garamizo/BipedRobot/imgs/exploded.png

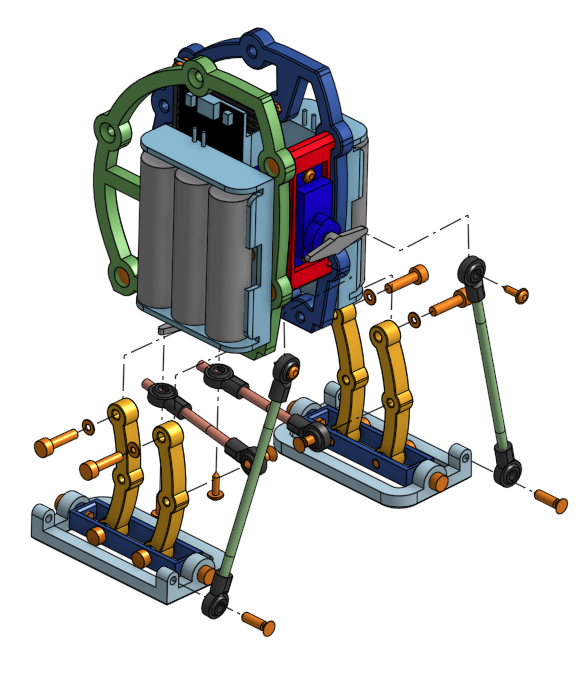
imgs/exploded.png
