garamizo/BipedRobot/imgs/giant.png

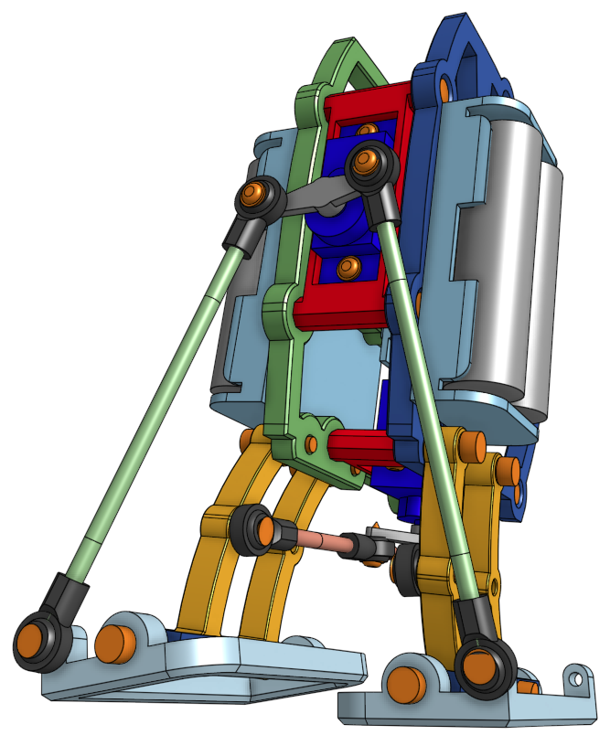
imgs/giant.png
