garamizo/BipedRobot/docs/drawings/BPD100B Robot.pdf

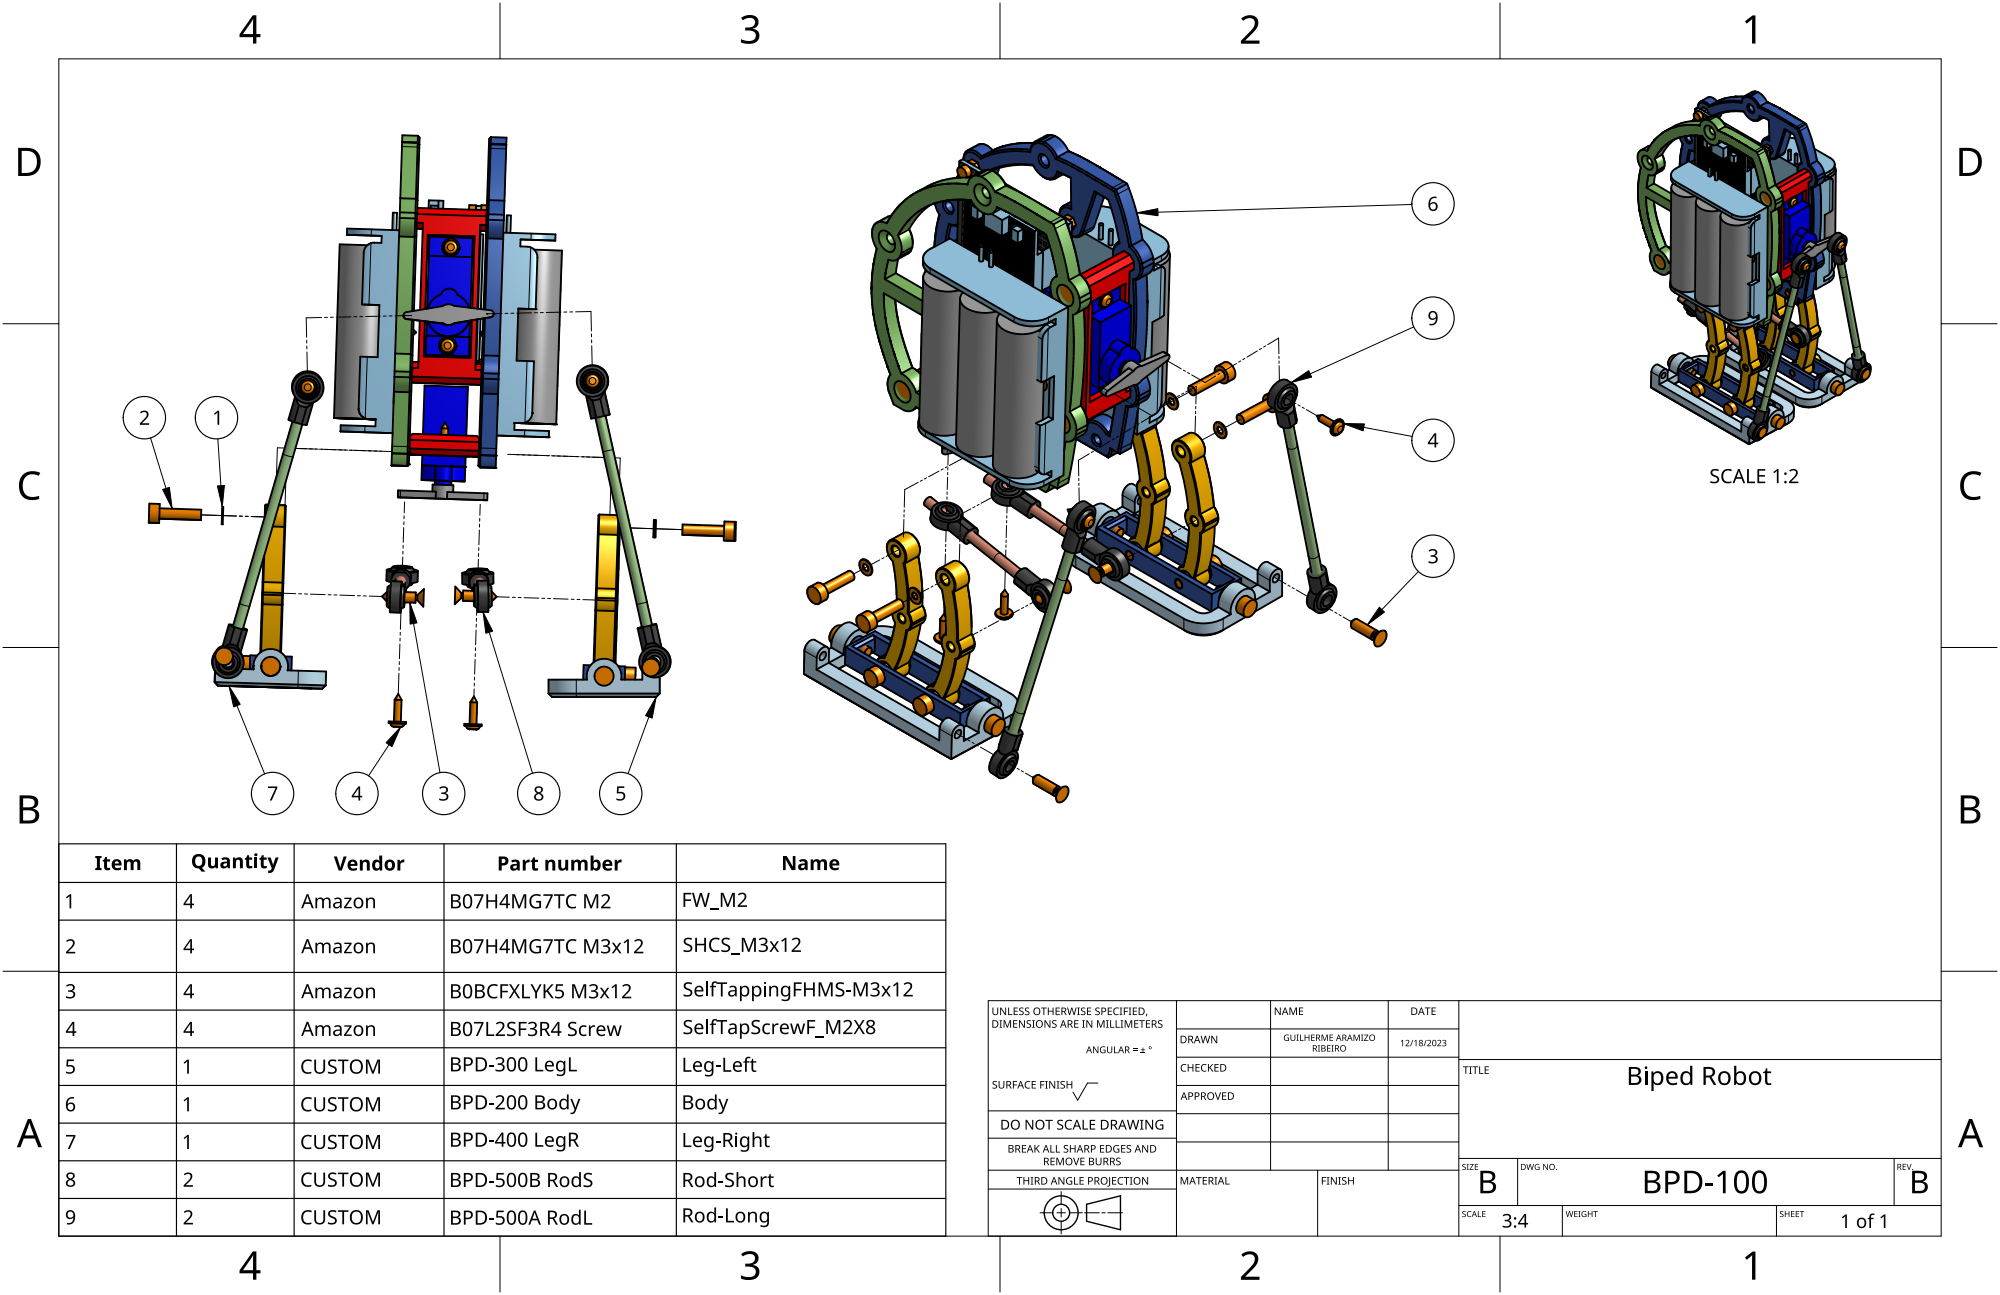
[picture p8: page 1]
