garamizo/BipedRobot/docs/drawings/BPD200B Body.pdf

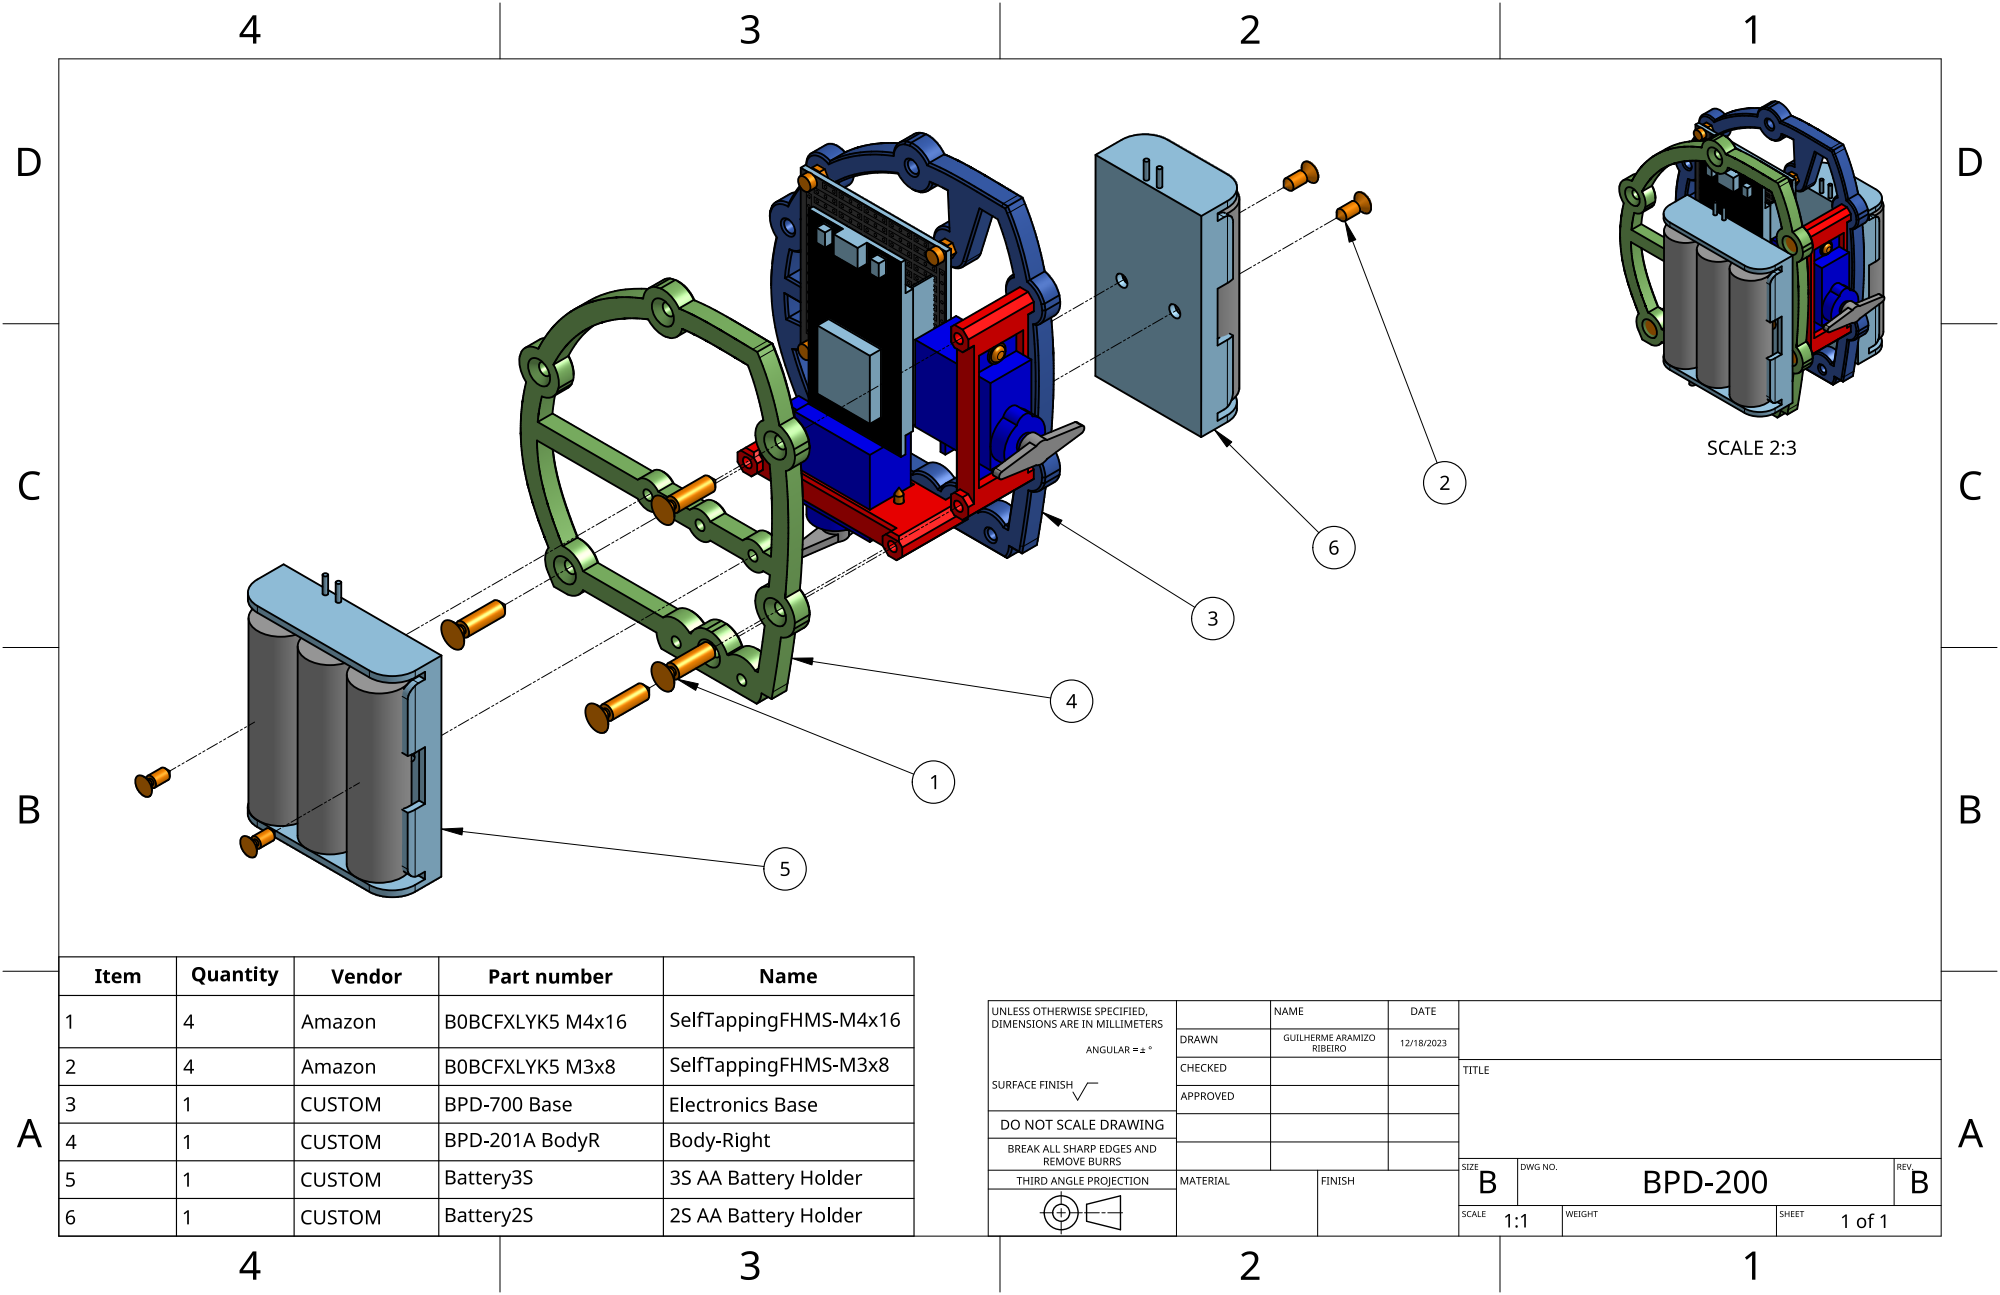
[picture p9: page 1]
