garamizo/BipedRobot/docs/drawings/BPD300A Leg Left.pdf

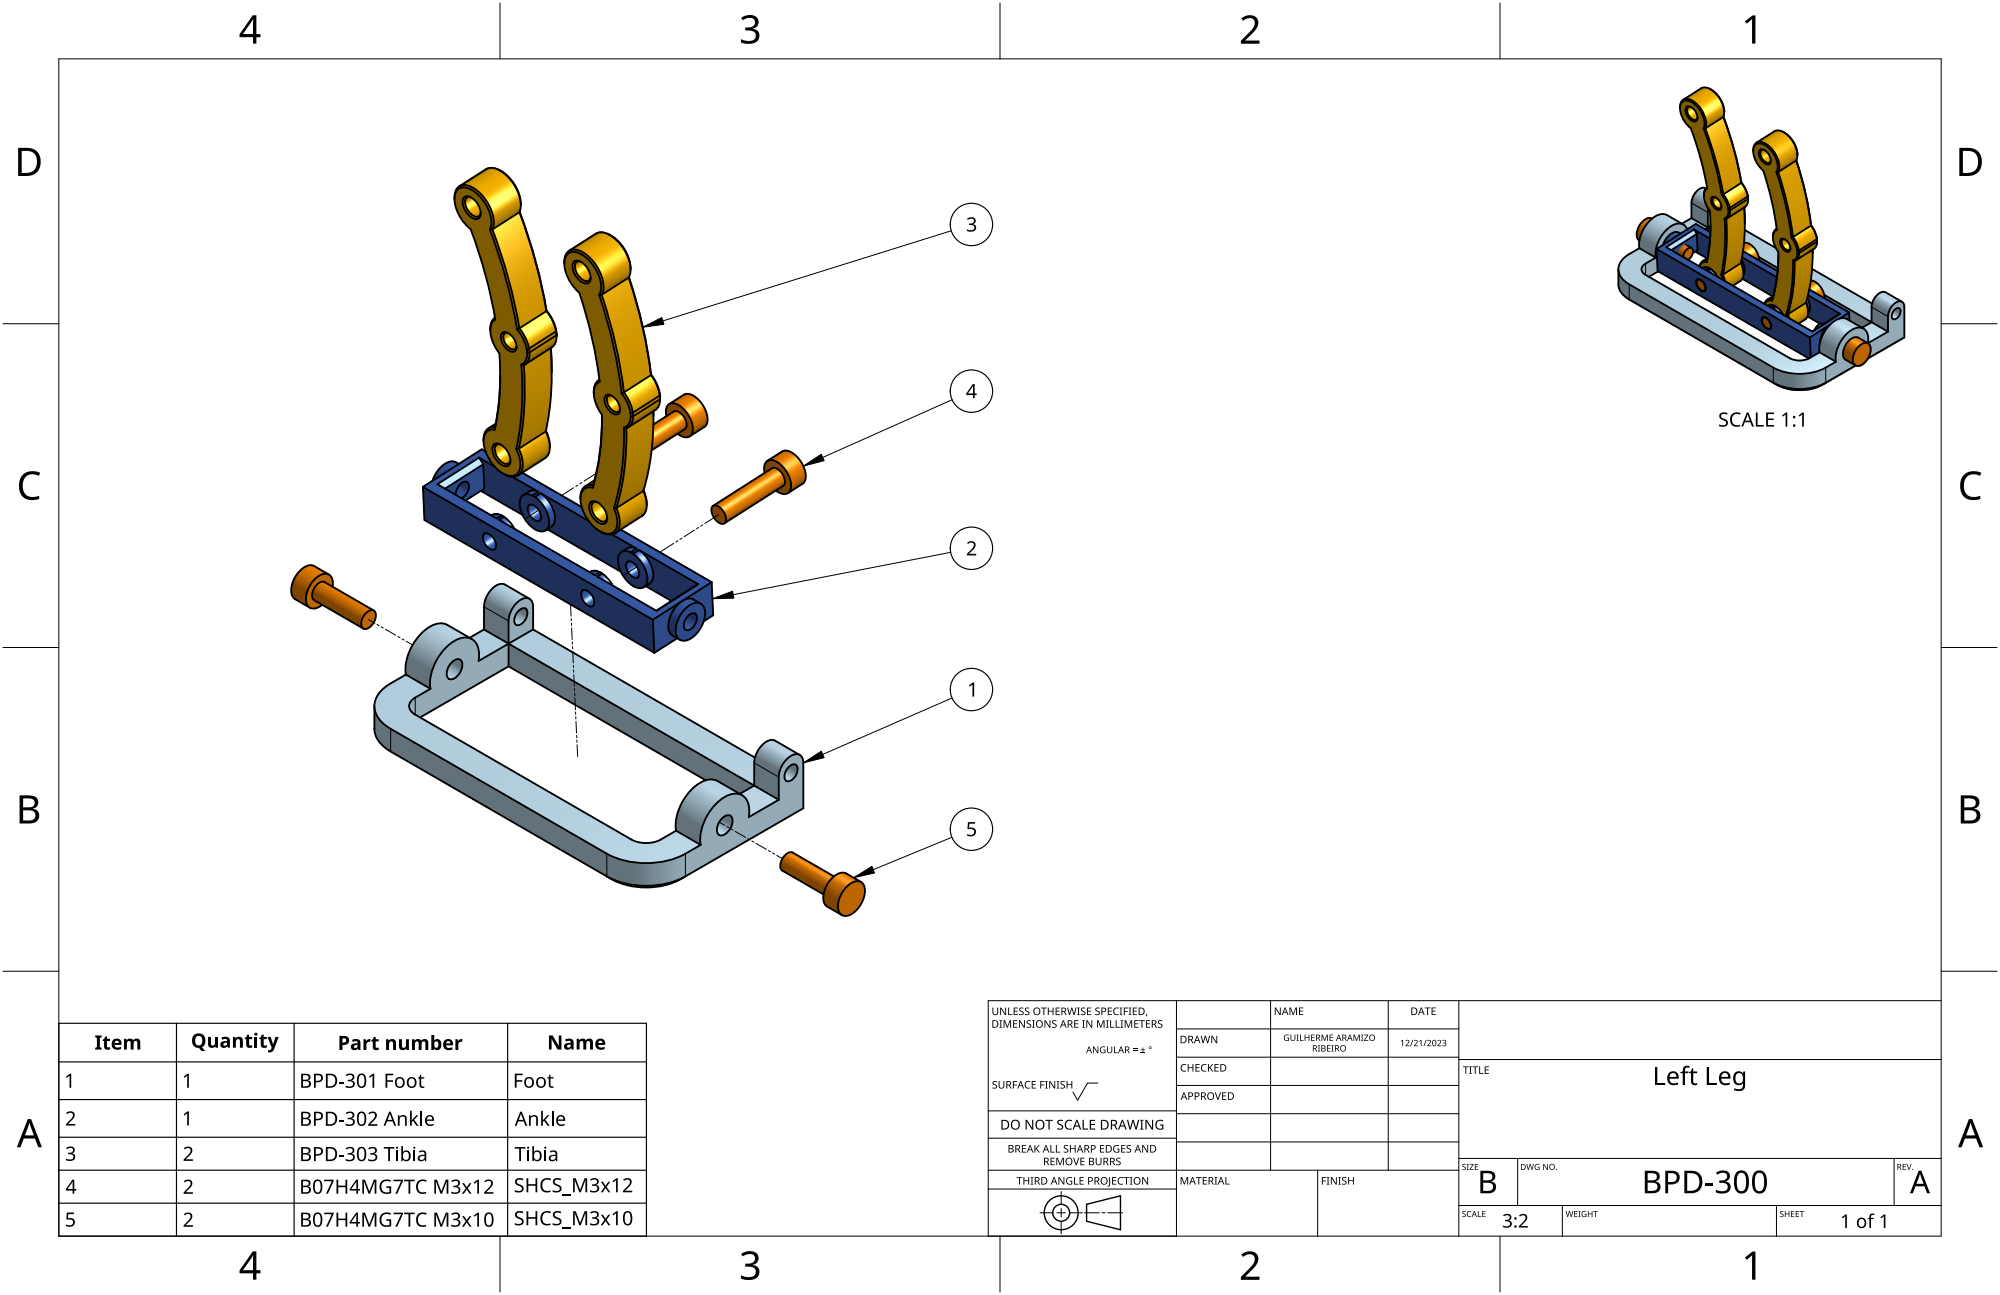
[picture p10: page 1]
